ThaoTranThi/Jetson-Carrier-Board-/Errata.xlsx

Items | Testing Problems | Possible Design Issues | Schematic Page Name | Solve
1 | Flash through USB is not working | U9 is not fitted on current board | [4] Power IN_OFF
 |  | R17 is fitted on current board | [4] Power IN_OFF | As NO FIT
 |  | R19 is not fitted on current board | [4] Power IN_OFF
 |  | R78 is fitted on current board | [4] Power IN_OFF | As NO FIT
 |  | R20 is not fitted on current board | [4] Power IN_OFF | As NO FIT
 |  | LED STATUS for POWER_EN affect to the voltage(not 5V) of POWER_EN | [5] Jetson Nano P1 | Removed Q9, Q10, Q11, LED1, LED2, LED3, R1, R2, R3
2 | UART logs record for booting from SD Card is not working | R28 is 4.7kohm, the reference design has not it | [5] Jetson Nano P1 | R28 to 0 ohm
3 | Other issues | Wrong position for R41 pull up resistor | [11] HUB USB3.0 | Moved R41 to VDD_HUB_3V3
 |  | C45, C46 for filtering 5V power supply is not enough(reference design use 560uF) | [5] Jetson Nano P1 | Changed C45, C46 to 330uF tantalum capacitor
 |  | Power enable switch for 3.3V is needed for peripherals | [3] Power Supply | Added the switch IC to be controlled from SYS_RST
 |  | Position of SD card behind of power connector is not good | [10] Peripheral | Fixed PCB for moving SD card connector
