ThaoTranThi/Jetson-Carrier-Board-/(list of files, drawings)

Other design files:
3DAS_4Camera.PrjPcb
[1] Index (Table of Content).SchDoc
[2] Block Diagram.SchDoc
[3] Power Supply.SchDoc
[4] Power ON_OFF.SchDoc
[5] Jetson Nano P1.SchDoc
[6] Jetson Nano P2.SchDoc
[7] Jetson Nano P3.SchDoc
[8] RJ45 Connector.SchDoc
[9] USB 2.0 .SchDoc
[10] Peripheral.SchDoc
[11] HUB USB3.0.SchDoc
[12] USB3.0_Connector1&2.SchDoc
[13] USB3.0_Connector3&4.SchDoc
[14] 1ST_AP1302 ISP.SchDoc
[15] 2ND_AP1302 ISP.SchDoc
[16] Camera Connector.SchDoc
